Rsa76d/FaikoutRSA/PCB/FaikoutETH/production/bom.csv

Designator | Footprint | Quantity | Value | LCSC Part #
C1 | C_0603 | 1 | 10uF 35V | C22367827
C10, C12, C23, C25 | C_0402 | 4 | 22uF | C105226
C11, C13, C14, C21, C22, C24, C28, C8, C9 | C_0201 | 9 | 100nF | C66938
C2, C4 | C_0201 | 2 | 100nF 35V | C181043
C20 | C_0201 | 1 | 10pF | C76921
C26, C27 | C_0201 | 2 | 20pF | C71879
C3 | C_0201 | 1 | 33nF | C5142554
C5 | C_0805 | 1 | 100uF 6.3V | C141660
C6 | C_0201 | 1 | 1uF | C87143
D1 | SMD1615 | 1 | XL-1615RGBC-2812B | C5349954
D2, D3 | DFN1006-2L | 2 | ~ | C5137770
D4 | D_0402 | 1 | D | C28642302
D5, D6 | D_0201 | 2 | BAT30F4 | C18197832
FB3, FB4, FB5 | L_0603 | 3 | FerriteBead | C14709
J1 | JST_EH_S5B-EH_1x05_P2.50mm_Horizontal | 1 | 1x5 | C265103
J4 | RC01516 | 1 | RJ45_LED | C708636
L1 | L_6x6 | 1 | 4.7uH | C32684
Q1 | SOT-363_SC-70-6 | 1 | BSS138PS | C193381
R1, R2, R3, R7 | R_0201 | 4 | 10k | C138117
R10, R11, R4, R9 | R_0201 | 4 | 49R9 | C100141
R12 | R_0201 | 1 | 3k01 1% | C320817
R5 | R_0201 | 1 | 33k | C473534
R6 | R_0201 | 1 | 30.9k 1% | C473585
R8 | R_0201 | 1 | 10k | C106225
TR1 | B1601S | 1 | B1601S | C510548
U1 | QFN-32-1EP_5x5mm_P0.5mm_EP3.7x3.7mm-hot | 1 | KSZ8851SNL | C633272
U2 | SOT-583-8 | 1 | TPS62933 | C3200405
U4 | ESP32-S3-MINI-1 | 1 | ESP32-S3-MINI-1 | C3013941
Y1 | Crystal-3.2x2.5 | 1 | Crystal_GND24 | C5155480
