Rsa76d/FaikoutRSA/PCB/FaikoutPOE/production/bom.csv

Designator | Footprint | Quantity | Value | LCSC Part #
C1, C11, C12, C13, C3, C4, C6, C8, C9 | C_0201 | 9 | 100nF | C66938
C10, C2, C5, C7 | C_0402 | 4 | 22uF | C105226
C14, C15 | C_0201 | 2 | 20pF | C71879
C16 | C_0201 | 1 | 10pF | C76921
C17, C34 | C_0201 | 2 | 100nF | C76934
C18 | C_0603 | 1 | 10uF 35V | C22367827
C19, C21, C22 | C_0201 | 3 | 100nF 35V | C181043
C20 | C_0201 | 1 | 33nF | C5142554
C23 | C_0805 | 1 | 100uF 6.3V | C141660
C25 | C_1206 | 1 | 10uF 50V | C13585
C26 | CP_Elec_6.3x7.7 | 1 | 100uF 50V | C72478
C36 | C_0201 | 1 | 1uF
D1, D2 | D_0201 | 2 | BAT30F4 | C18197832
D10, D5 | D_0402 | 2 | D | C28642302
D11, D7 | DFN1006-2L | 2 | ~ | C5137770
D4 | SMD1615-Side | 1 | XL-1615RGBC-2812B | C5349954
D6 | D_SMA | 1 | SMAJ58A
D8, D9 | TO-269AA-BR | 2 | MB4S | C232847
F4 | Fuse_1210 | 1 | 1210L150/33WR | C42376299
FB3, FB4, FB5 | L_0603 | 3 | FerriteBead | C14709
J1 | RC01516 | 1 | RJ45_LED | C708636
J3 | JST_EH_S5B-EH_1x05_P2.50mm_Horizontal | 1 | S21 | C265103
L1 | L_6x6 | 1 | 4.7uH | C32684
L14, L15, L16, L17, L18, L19 | L_0805 | 6 | CBG201209U121T | C41330
M1 | Ag9900-LP | 1 | Ag9912-LP | C6789853
Q1, Q2 | SOT-363_SC-70-6 | 2 | BSS138PS | C193381
R1, R2, R3, R4, R5 | R_0201 | 5 | 49R9 | C100141
R10, R17 | R_0201 | 2 | 1k | C270365
R11 | R_0201 | 1 | 33k | C473534
R13, R16, R21, R22, R24, R6, R7, R9 | R_0201 | 8 | 10k | C106225
R18, R19 | R_0201 | 2 | 4k7 | C138135
R20 | R_2512 | 1 | 200 1W | C2907575
R23 | R_0201 | 1 | 30.9k 1% | C473585
R8 | R_0201 | 1 | 3k01 1% | C320817
TR1 | B1601S | 1 | B1601S | C510548
U1 | QFN-32-1EP_5x5mm_P0.5mm_EP3.7x3.7mm-hot | 1 | KSZ8851SNL | C633272
U2 | ESP32-S3-MINI-1 | 1 | ESP32-S3-MINI-1 | C3013941
U3 | SOP-4_4.4x2.6mm_P1.27mm | 1 | TCMT1100 | C118298
U5 | SOP-4_4.4x2.6mm_P1.27mm | 1 | TCMT1100 | MPN
U6 | SOT-583-8 | 1 | TPS62933 | C3200405
Y1 | Crystal-3.2x2.5 | 1 | Crystal_GND24 | C5155480
