Rsa76d/FaikoutRSA/(list of files, cad)

Other CAD files:
PCB/Faikout/FaikoutT.stl
PCB/FaikoutETH/FaikoutT.stl
PCB/FaikoutPOE/FaikoutT.stl
PCB/Faikout/FaikoutB.stl
PCB/FaikoutETH/FaikoutB.stl
PCB/FaikoutPOE/FaikoutC.stl
PCB/Faikout/FaikoutC.stl
PCB/FaikoutETH/FaikoutC.stl
PCB/FaikoutPOE/FaikoutB.stl
PCB/Faikout/FaikoutC.scad
PCB/Faikout/FaikoutT.scad
PCB/FaikoutETH/FaikoutB.scad
PCB/FaikoutETH/FaikoutC.scad
PCB/FaikoutETH/FaikoutT.scad
PCB/FaikoutPOE/FaikoutC.scad
PCB/FaikoutPOE/FaikoutT.scad
