Rsa76d/FaikoutRSA/PCB/FaikoutETH/Faikout.kicad_pcb

## KiCad design PCB/FaikoutETH/Faikout.kicad_pcb (2026-10-10)

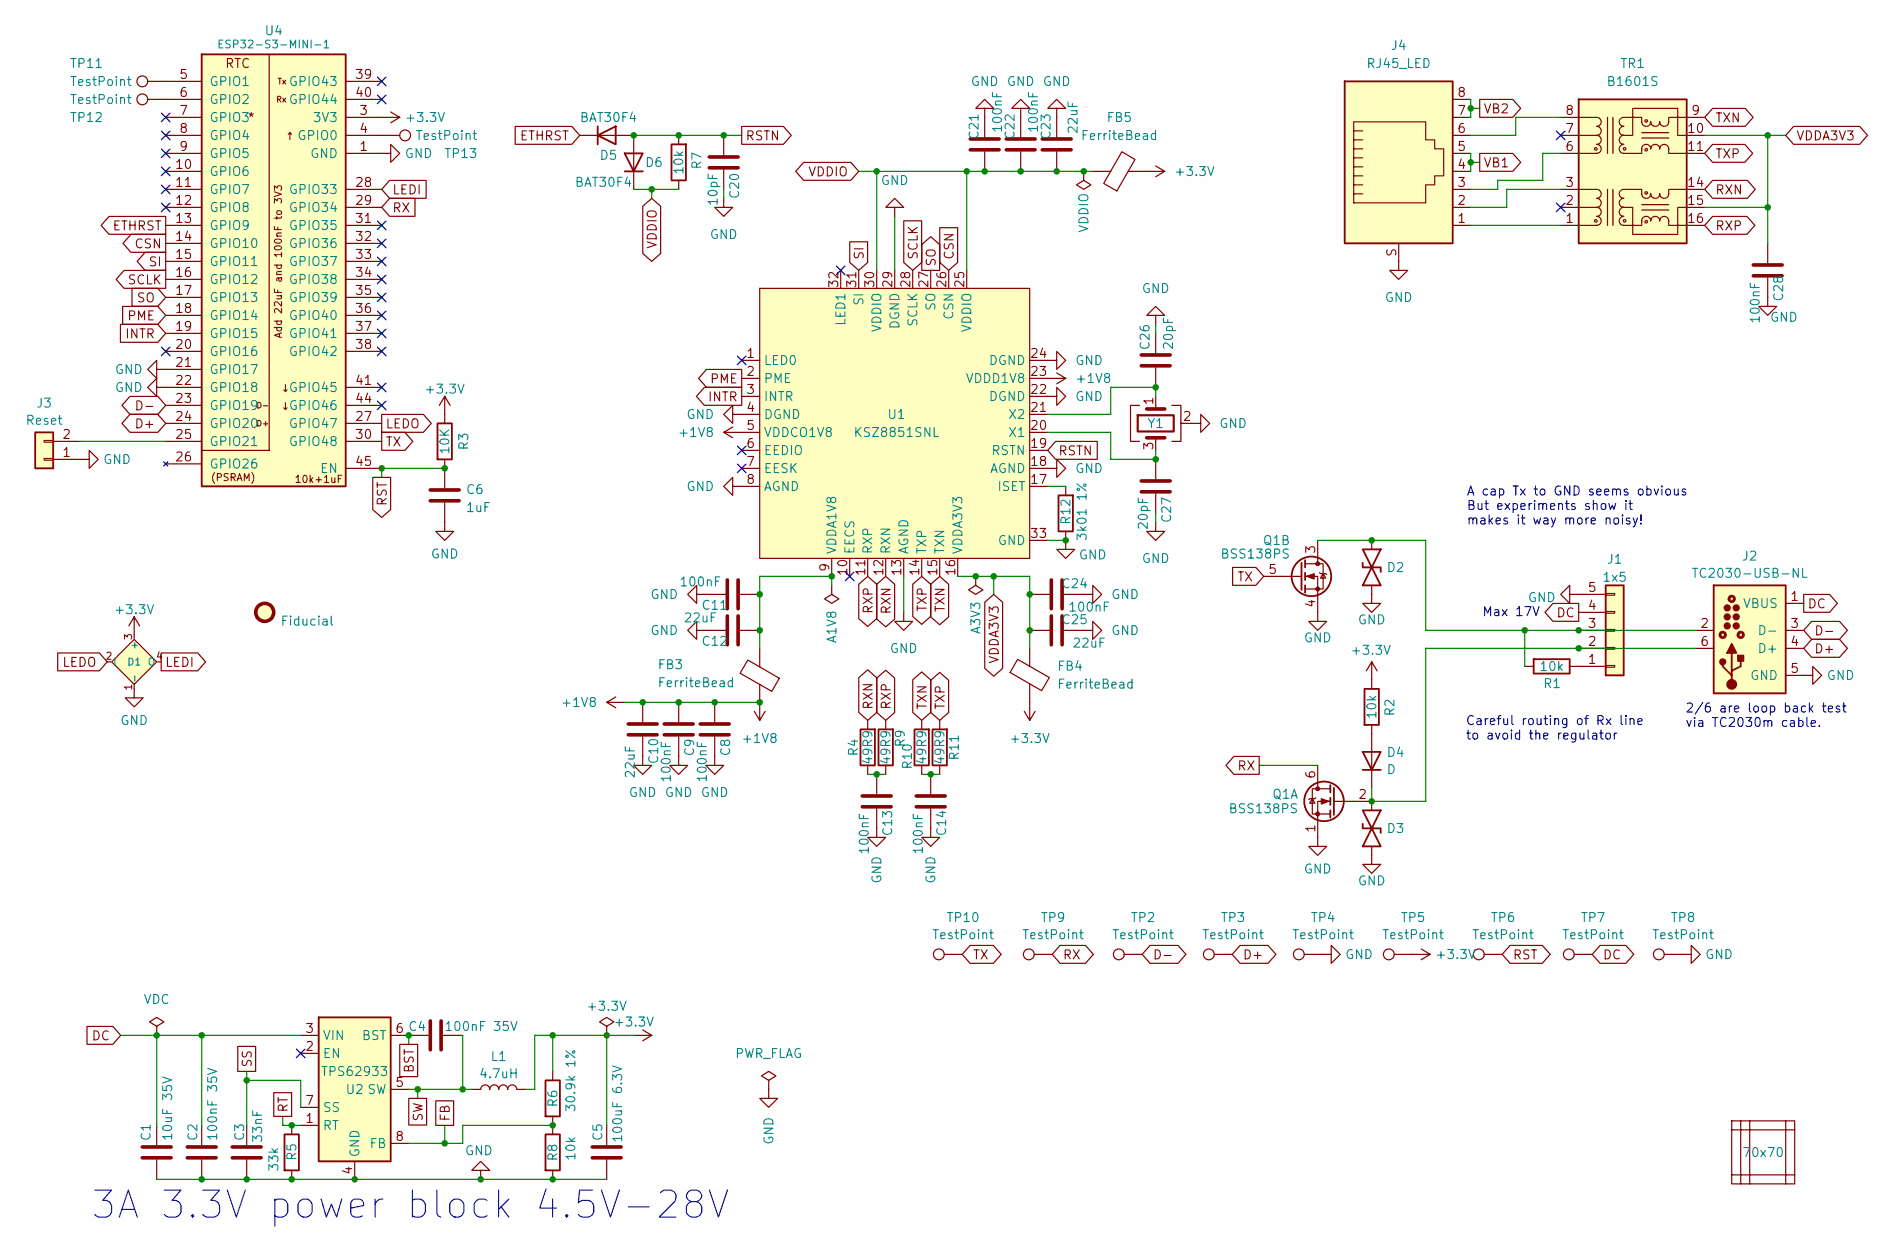
[picture p1: schematic Faikout.kicad_sch]

Parts:
C1: 10uF 35V; C_0603; MPN C22367827
C2, C4: 100nF 35V; C_0201; MPN C181043
C3: 33nF; C_0201; MPN C5142554
C5: 100uF 6.3V; C_0805; MPN C141660
C6: 1uF; C_0201; MPN C87143
C8, C9, C11, C13, C14, C21, C22, C24, C28: 100nF; C_0201; MPN C66938
C10, C12, C23, C25: 22uF; C_0402; MPN C105226
C20: 10pF; C_0201; MPN C76921
C26, C27: 20pF; C_0201; MPN C71879
D1: XL-1615RGBC-2812B; SMD1615; MPN C5349954
D2, D3: DFN1006-2L; MPN C5137770
D4: D; D_0402; MPN C28642302
D5, D6: BAT30F4; D_0201; MPN C18197832
FB3, FB4, FB5: FerriteBead; L_0603; MPN C14709
FID2: Fiducial; Fiducial_1mm_Mask2mm
J1: 1x5; JST_EH_S5B-EH_1x05_P2.50mm_Horizontal; MPN C265103
J2: TC2030-USB-NL; Tag-Connect_TC2030-IDC-NL_2x03_P1.27mm_Vertical
J3: Reset; AA-Pad
J4: RJ45_LED; RC01516; MPN C708636
L1: 4.7uH; L_6x6; MPN C32684
PCB1: 70x70; PCB7070
Q1: BSS138PS; SOT-363_SC-70-6; MPN C193381
R1, R2, R7: 10k; R_0201; MPN C138117
R3: 10K; R_0201; MPN C138117
R4, R9, R10, R11: 49R9; R_0201; MPN C100141
R5: 33k; R_0201; MPN C473534
R6: 30.9k 1%; R_0201; MPN C473585
R8: 10k; R_0201; MPN C106225
R12: 3k01 1%; R_0201; MPN C320817
TP2, TP3, TP4, TP5, TP6, TP7, TP8, TP9, TP10, TP11, TP12, TP13: TestPoint; PAD-2mm
TR1: B1601S; MPN C510548
U1: KSZ8851SNL; QFN-32-1EP_5x5mm_P0.5mm_EP3.7x3.7mm-hot; MPN C633272
U2: TPS62933; SOT-583-8; MPN C3200405
U4: ESP32-S3-MINI-1; MPN C3013941
V3, V4, V5, V6, V7: VCUT70N
Y1: Crystal_GND24; Crystal-3.2x2.5; MPN C5155480

Connections:
+1V8: C8.1, C9.1, C10.1, FB3.1, U1.5 (VDDCO1V8), U1.23 (VDDD1V8)
+3.3V: C5.1, D1.3 (+), FB4.2, FB5.2, L1.2, R2.1, R3.1, R6.1, TP5.1 (1_1), U4.3 (3V3)
BST: C4.1, U2.6 (BST)
CSN: U1.26 (CSN), U4.14 (GPIO10)
D+: J2.4 (D+), TP3.1 (1_1), U4.24 (GPIO20)
D-: J2.3 (D-), TP2.1 (1_1), U4.23 (GPIO19)
DC: C1.1, C2.1, J1.4, J2.1 (VBUS), TP7.1 (1_1), U2.3 (VIN)
ETHRST: D5.1 (K), U4.13 (GPIO9)
FB: R6.2, R8.1, U2.8 (FB)
GND: C1.2, C2.2, C3.2, C5.2, C6.2, C8.2, C9.2, C10.2, C11.2, C12.2, C13.2, C14.2, C20.2, C21.2, C22.2, C23.2, C24.2, C25.2, C26.2, C27.2, C28.2, D1.1 (-), D2.1, D3.1, J1.5, J2.5 (GND), J3.1, J4.S, Q1.1 (SN), Q1.4 (DP), R5.2, R8.2, R12.1, TP4.1 (1_1), TP8.1 (1_1), U1.4 (DGND), U1.8 (AGND), U1.13 (AGND), U1.18 (AGND), U1.22 (DGND), U1.24 (DGND), U1.29 (DGND), U1.33 (GND), U2.4 (GND), U4.1 (GND), U4.2 (GND), U4.21 (GPIO17), U4.22 (GPIO18), U4.42 (GND), U4.43 (GND), U4.46 (GND), U4.47 (GND), U4.48 (GND), U4.49 (GND), U4.50 (GND), U4.51 (GND), U4.52 (GND), U4.53 (GND), U4.54 (GND), U4.55 (GND), U4.56 (GND), U4.57 (GND), U4.58 (GND), U4.59 (GND), U4.60 (GND), U4.61 (GND), U4.62 (GND), U4.63 (GND), U4.64 (GND), U4.65 (GND), Y1.2 (G), Y1.4 (G)
INTR: U1.3 (INTR), U4.19 (GPIO15)
LEDI: D1.4 (O), U4.28 (GPIO33)
LEDO: D1.2 (I), U4.27 (GPIO47)
unnamed: C13.1, R4.1, R9.1
unnamed: C14.1, R10.1, R11.1
unnamed: D4.2 (A), R2.2
unnamed: D3.2, D4.1 (K), J1.2, J2.6, Q1.2 (GN)
unnamed: J1.1, R1.1
unnamed: D2.2, J1.3, J2.2, Q1.3 (SP), R1.2
unnamed: J3.2, U4.25 (GPIO21)
unnamed: J4.3, TR1.6 (RD+)
unnamed: J4.6, TR1.8 (RD-)
unnamed: J4.1, TR1.1 (TD+)
unnamed: J4.2, TR1.3 (TD-)
unnamed: R12.2, U1.17 (ISET)
unnamed: C11.1, C12.1, FB3.2, U1.9 (VDDA1V8)
unnamed: C27.1, U1.20 (X1), Y1.3
unnamed: C26.1, U1.21 (X2), Y1.1
unnamed: TP13.1 (1_1), U4.4 (GPIO0)
unnamed: TP11.1 (1_1), U4.5 (GPIO1)
unnamed: TP12.1 (1_1), U4.6 (GPIO2)
PME: U1.2 (PME), U4.18 (GPIO14)
RST: C6.1, R3.2, TP6.1 (1_1), U4.45 (EN)
RSTN: C20.1, D5.2 (A), D6.2 (A), R7.2, U1.19 (RSTN)
RT: R5.1, U2.1 (RT)
RX: Q1.6 (DN), TP9.1 (1_1), U4.29 (GPIO34)
RXN: R4.2, TR1.14 (TX-), U1.12 (RXN)
RXP: R9.2, TR1.16 (TX+), U1.11 (RXP)
SCLK: U1.28 (SCLK), U4.16 (GPIO12)
SI: U1.31 (SI), U4.15 (GPIO11)
SO: U1.27 (SO), U4.17 (GPIO13)
SS: C3.1, U2.7 (SS)
SW: C4.2, L1.1, U2.5 (SW)
TX: Q1.5 (GP), TP10.1 (1_1), U4.30 (GPIO48)
TXN: R10.2, TR1.9 (RX-), U1.15 (TXN)
TXP: R11.2, TR1.11 (RX+), U1.14 (TXP)
VB1: J4.4, J4.5
VB2: J4.7, J4.8
VDDA3V3: C24.1, C25.1, C28.1, FB4.1, TR1.10 (C_RX), TR1.15 (C_TX), U1.16 (VDDA3V3)
VDDIO: C21.1, C22.1, C23.1, D6.1 (K), FB5.1, R7.1, U1.25 (VDDIO), U1.30 (VDDIO)

Notes on the sheet:
Careful routing of Rx line to avoid the regulator
Max 17V
2/6 are loop back test via TC2030m cable.
A cap Tx to GND seems obvious But experiments show it makes it way more noisy!
3A 3.3V power block 4.5V-28V

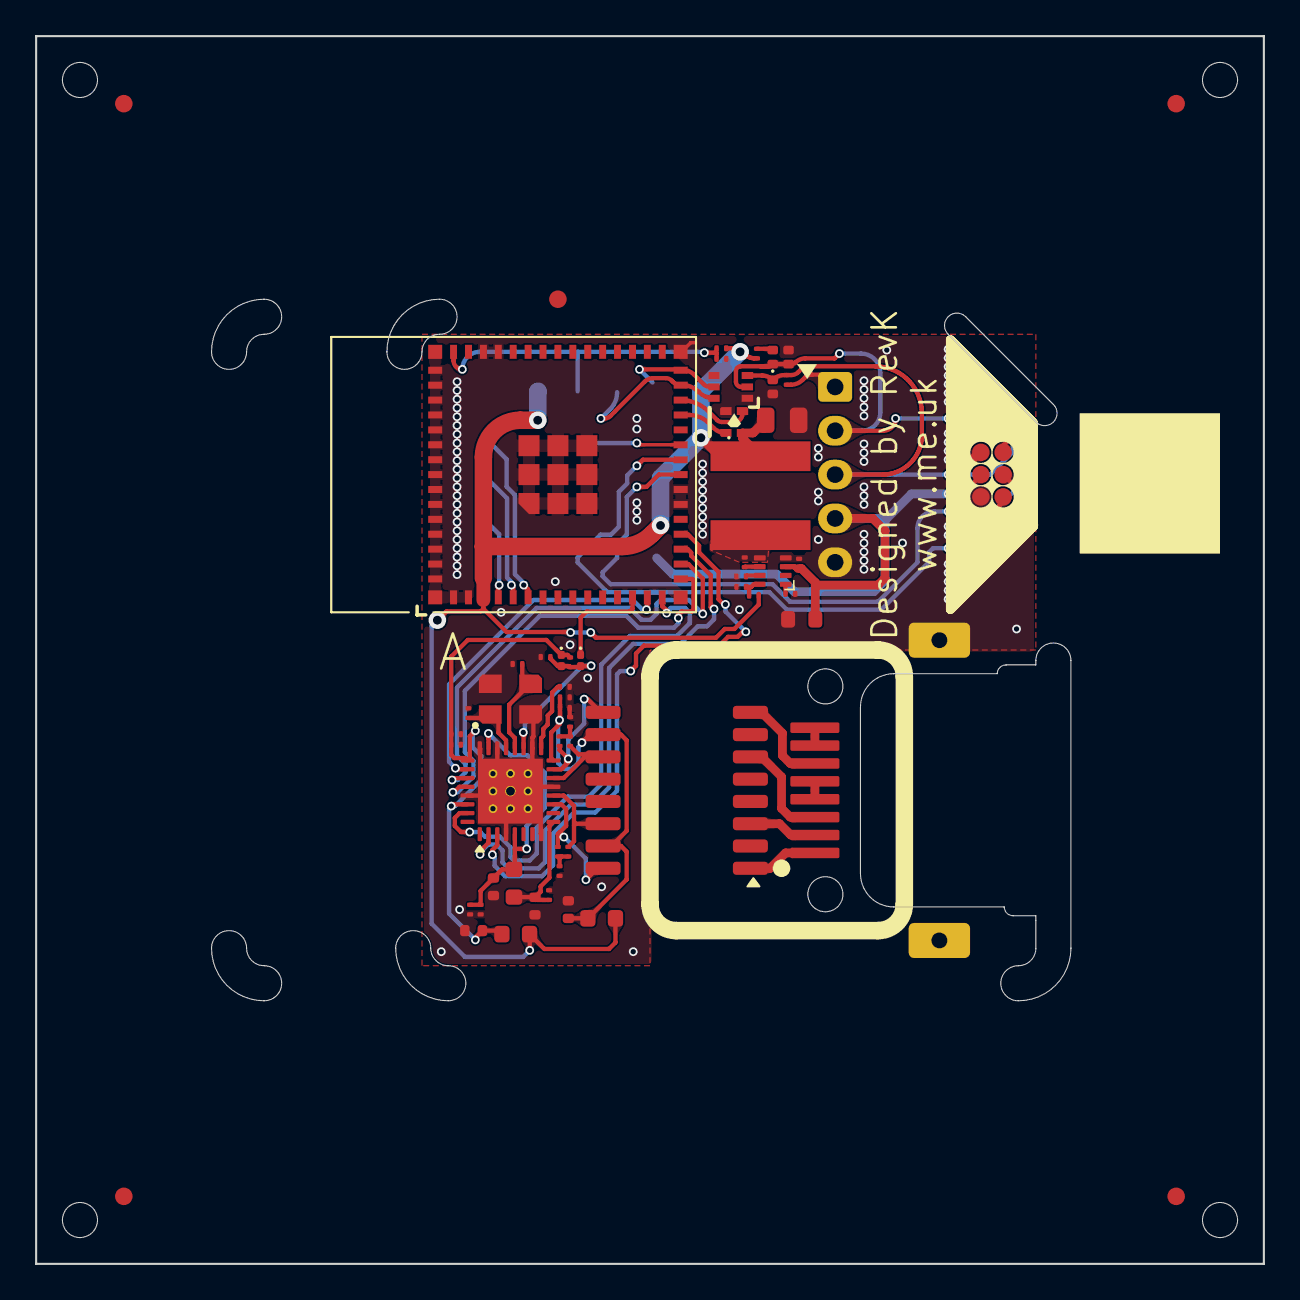
[picture p2: board PCB/FaikoutETH/Faikout.kicad_pcb from above]

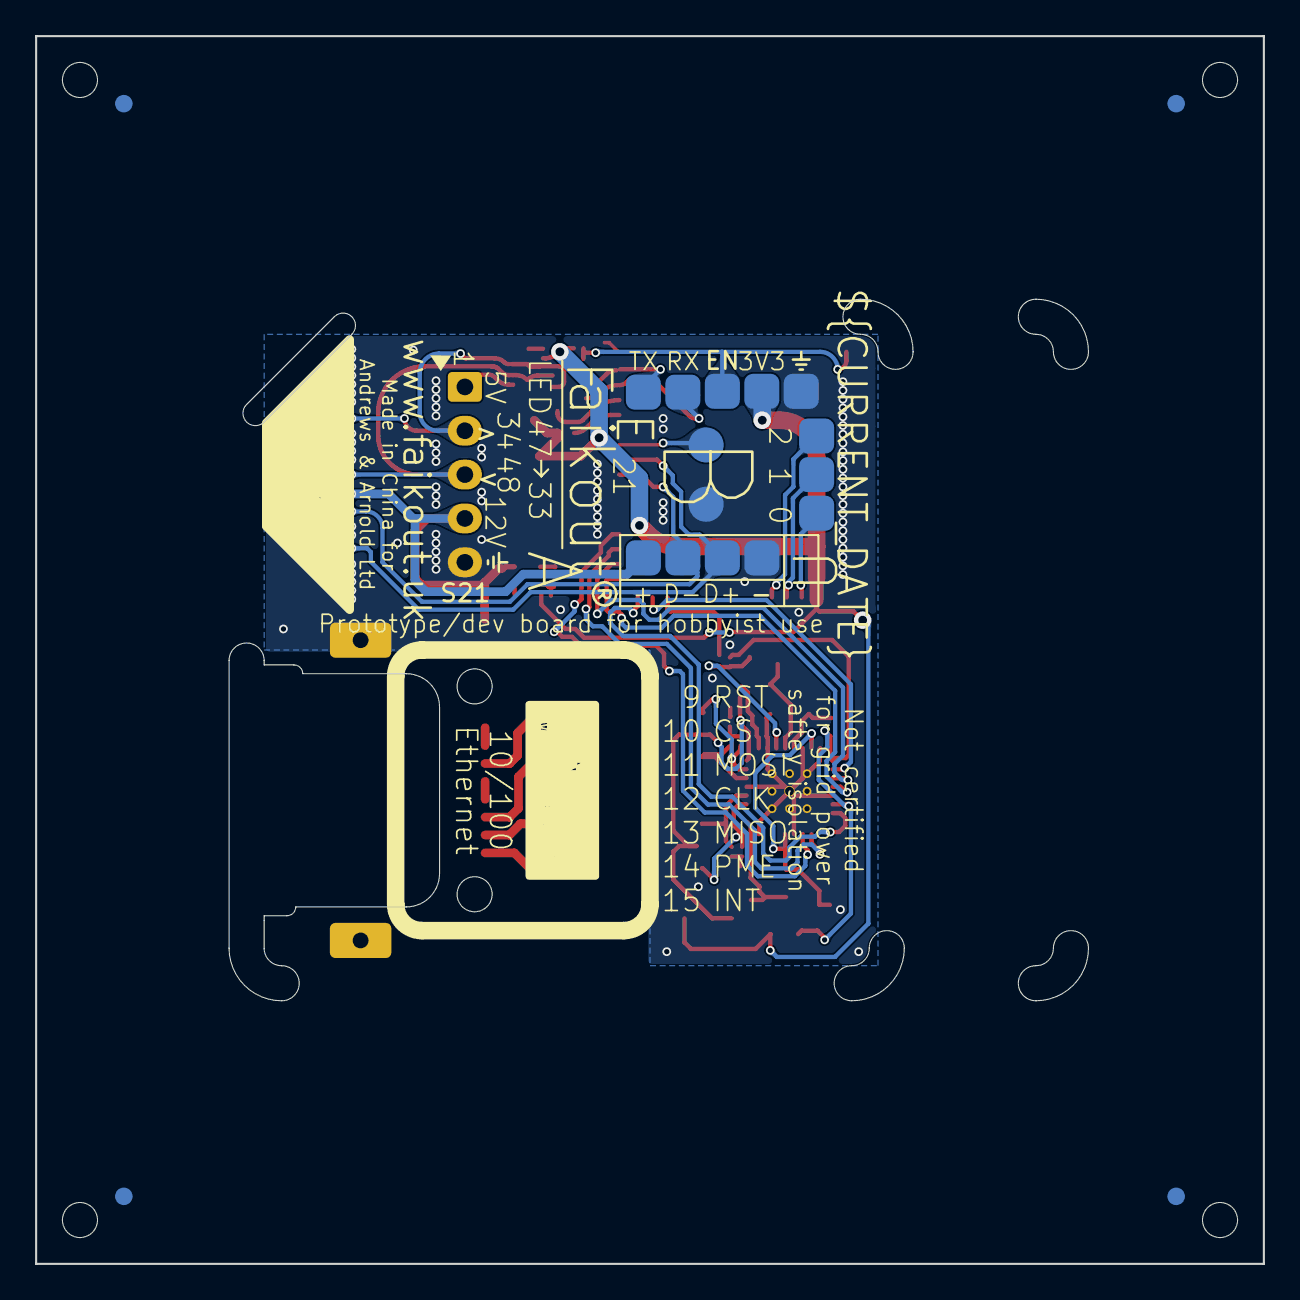
[picture p3: board PCB/FaikoutETH/Faikout.kicad_pcb from below]

Board: 2 copper layers, 70.0 x 70.0 mm, 73 parts (14 on the bottom side), 50 nets.
