Rsa76d/FaikoutRSA/PCB/FaikoutPOE/Faikout.kicad_pcb

## KiCad design PCB/FaikoutPOE/Faikout.kicad_pcb (2026-10-10)

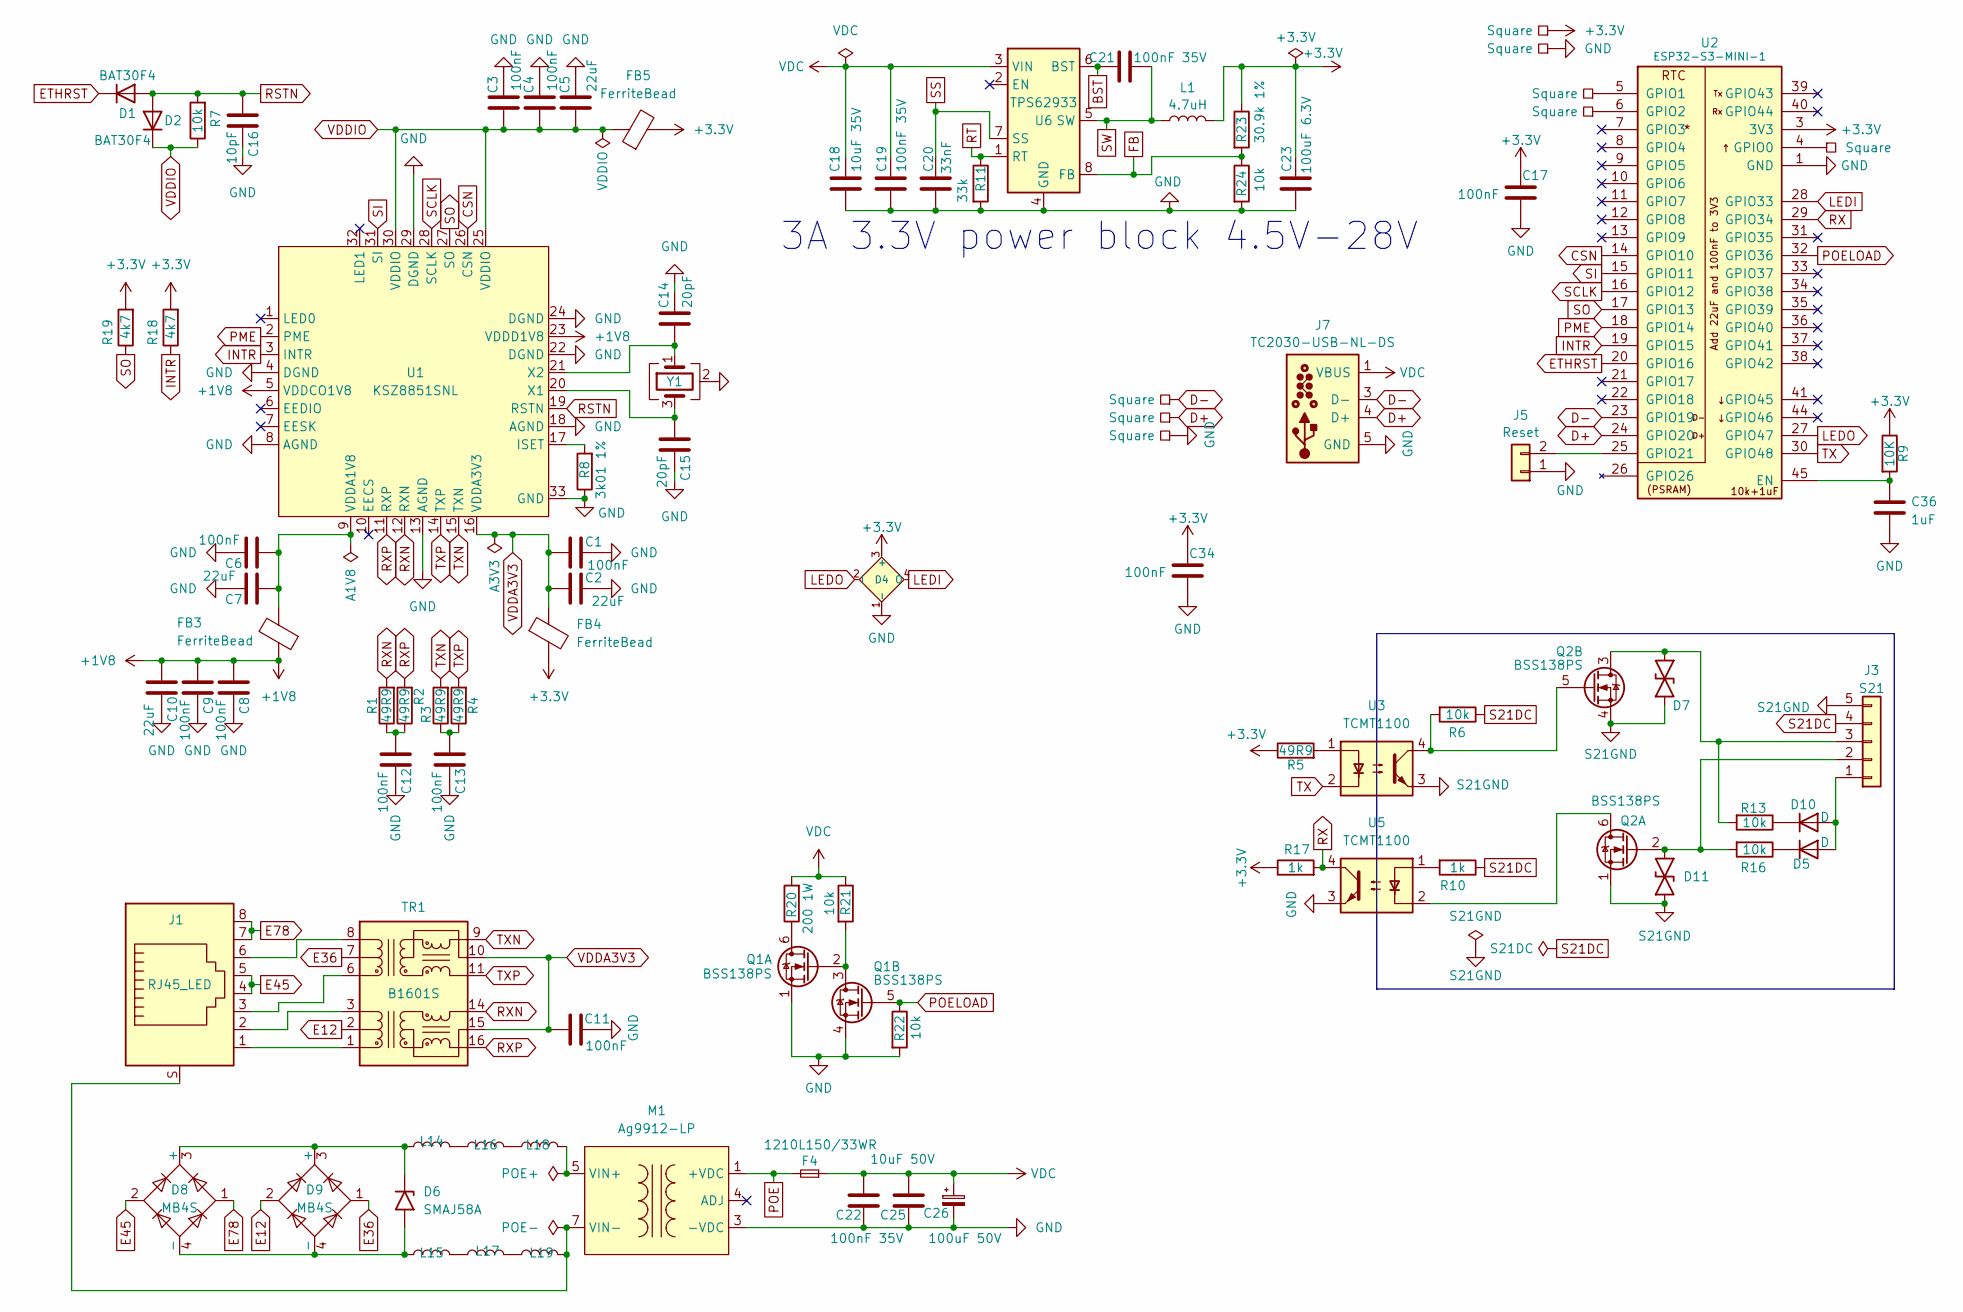
[picture p4: schematic Faikout.kicad_sch]

Parts:
C1, C3, C4, C6, C8, C9, C11, C12, C13: 100nF; C_0201; MPN C66938
C2, C5, C7, C10: 22uF; C_0402; MPN C105226
C14, C15: 20pF; C_0201; MPN C71879
C16: 10pF; C_0201; MPN C76921
C17, C34: 100nF; C_0201; MPN C76934
C18: 10uF 35V; C_0603; MPN C22367827
C19, C21, C22: 100nF 35V; C_0201; MPN C181043
C20: 33nF; C_0201; MPN C5142554
C23: 100uF 6.3V; C_0805; MPN C141660
C25: 10uF 50V; C_1206; MPN C13585
C26: 100uF 50V; CP_Elec_6.3x7.7; MPN C72478
C36: 1uF; C_0201
D1, D2: BAT30F4; D_0201; MPN C18197832
D4: XL-1615RGBC-2812B; SMD1615-Side; MPN C5349954
D5, D10: D; D_0402; MPN C28642302
D6: SMAJ58A; D_SMA
D7, D11: DFN1006-2L; MPN C5137770
D8, D9: MB4S; TO-269AA-BR; MPN C232847
F4: 1210L150/33WR; Fuse_1210; MPN C42376299
FB3, FB4, FB5: FerriteBead; L_0603; MPN C14709
J1: RJ45_LED; RC01516; MPN C708636
J3: S21; JST_EH_S5B-EH_1x05_P2.50mm_Horizontal; MPN C265103
J5: Reset; AA-Pad
J7: TC2030-USB-NL-DS; Tag-Connect_TC2030-IDC-NL_2x03_P1.27mm_Vertical
L1: 4.7uH; L_6x6; MPN C32684
L14, L15, L16, L17, L18, L19: CBG201209U121T; L_0805; MPN C41330
M1: Ag9912-LP; Ag9900-LP; MPN C6789853
P1, P2, P3, P4, P5, P6, P7, P8: Square; PAD-2mm
Q1, Q2: BSS138PS; SOT-363_SC-70-6; MPN C193381
R1, R2, R3, R4, R5: 49R9; R_0201; MPN C100141
R6, R7, R13, R16, R21, R22, R24: 10k; R_0201; MPN C106225
R8: 3k01 1%; R_0201; MPN C320817
R9: 10K; R_0201; MPN C106225
R10, R17: 1k; R_0201; MPN C270365
R11: 33k; R_0201; MPN C473534
R18, R19: 4k7; R_0201; MPN C138135
R20: 200 1W; R_2512; MPN C2907575
R23: 30.9k 1%; R_0201; MPN C473585
TR1: B1601S; MPN C510548
U1: KSZ8851SNL; QFN-32-1EP_5x5mm_P0.5mm_EP3.7x3.7mm-hot; MPN C633272
U2: ESP32-S3-MINI-1; MPN C3013941
U3: TCMT1100; SOP-4_4.4x2.6mm_P1.27mm; MPN C118298
U5: TCMT1100; SOP-4_4.4x2.6mm_P1.27mm; MPN MPN
U6: TPS62933; SOT-583-8; MPN C3200405
Y1: Crystal_GND24; Crystal-3.2x2.5; MPN C5155480

Connections:
+1V8: C8.1, C9.1, C10.1, FB3.1, U1.5 (VDDCO1V8), U1.23 (VDDD1V8)
+3.3V: C17.2, C23.1, C34.2, D4.3 (+), FB4.2, FB5.2, L1.2, P7.1 (P_1), R5.1, R9.1, R17.1, R18.2, R19.2, R23.1, U2.3 (3V3)
BST: C21.1, U6.6 (BST)
CSN: U1.26 (CSN), U2.14 (GPIO10)
D+: J7.4 (D+), P3.1 (P_1), U2.24 (GPIO20)
D-: J7.2 (NC), J7.3 (D-), J7.6 (NC), P2.1 (P_1), U2.23 (GPIO19)
E12: D9.2, TR1.2 (C_TD)
E36: D9.1, TR1.7 (C_RD)
E45: D8.2, J1.4, J1.5
E78: D8.1, J1.7, J1.8
ETHRST: D1.1 (K), U2.20 (GPIO16)
FB: R23.2, R24.1, U6.8 (FB)
GND: C1.2, C2.2, C3.2, C4.2, C5.2, C6.2, C7.2, C8.2, C9.2, C10.2, C11.2, C12.2, C13.2, C14.2, C15.2, C16.2, C17.1, C18.2, C19.2, C20.2, C22.2, C23.2, C25.1, C26.2, C34.1, C36.2, D4.1 (-), J5.1, J7.5 (GND), M1.3 (-VDC), P4.1 (P_1), P8.1 (P_1), Q1.1 (SN), Q1.4 (DP), R8.1, R11.2, R22.2, R24.2, U1.4 (DGND), U1.8 (AGND), U1.13 (AGND), U1.18 (AGND), U1.22 (DGND), U1.24 (DGND), U1.29 (DGND), U1.33 (GND), U2.1 (GND), U2.2 (GND), U2.42 (GND), U2.43 (GND), U2.46 (GND), U2.47 (GND), U2.48 (GND), U2.49 (GND), U2.50 (GND), U2.51 (GND), U2.52 (GND), U2.53 (GND), U2.54 (GND), U2.55 (GND), U2.56 (GND), U2.57 (GND), U2.58 (GND), U2.59 (GND), U2.60 (GND), U2.61 (GND), U2.62 (GND), U2.63 (GND), U2.64 (GND), U2.65 (GND), U5.3, U6.4 (GND), Y1.2 (G), Y1.4 (G)
INTR: R18.1, U1.3 (INTR), U2.19 (GPIO15)
LEDI: D4.4 (O), U2.28 (GPIO33)
LEDO: D4.2 (I), U2.27 (GPIO47)
unnamed: C12.1, R1.1, R2.1
unnamed: C13.1, R3.1, R4.1
unnamed: D5.1 (K), R16.1
unnamed: D6.1 (A1), D8.3 (+), D9.3 (+), L14.1
unnamed: D6.2 (A2), D8.4 (-), D9.4 (-), L15.1
unnamed: D5.2 (A), D10.2 (A), J3.1
unnamed: D10.1 (K), R13.1
unnamed: D11.1, J3.2, Q2.2 (GN), R16.2
unnamed: D7.2, J3.3, Q2.3 (SP), R13.2
unnamed: J5.2, U2.25 (GPIO21)
unnamed: L14.2, L16.1
unnamed: L15.2, L17.1
unnamed: L16.2, L18.1
unnamed: L17.2, L19.1
unnamed: P1.1 (P_1), U2.4 (GPIO0)
unnamed: P5.1 (P_1), U2.5 (GPIO1)
unnamed: P6.1 (P_1), U2.6 (GPIO2)
unnamed: Q1.6 (DN), R20.1
unnamed: Q1.2 (GN), Q1.3 (SP), R21.2
unnamed: Q2.6 (DN), U5.2
unnamed: Q2.5 (GP), R6.2, U3.4
unnamed: R5.2, U3.1
unnamed: R10.2, U5.1
unnamed: J1.3, TR1.6 (RD+)
unnamed: J1.6, TR1.8 (RD-)
unnamed: J1.1, TR1.1 (TD+)
unnamed: J1.2, TR1.3 (TD-)
unnamed: R8.2, U1.17 (ISET)
unnamed: C6.1, C7.1, FB3.2, U1.9 (VDDA1V8)
unnamed: C15.1, U1.20 (X1), Y1.3
unnamed: C14.1, U1.21 (X2), Y1.1
unnamed: C36.1, R9.2, U2.45 (EN)
PME: U1.2 (PME), U2.18 (GPIO14)
POE: F4.2, M1.1 (+VDC), M1.2 (+VDC)
POELOAD: Q1.5 (GP), R22.1, U2.32 (GPIO36)
RSTN: C16.1, D1.2 (A), D2.2 (A), R7.2, U1.19 (RSTN)
RT: R11.1, U6.1 (RT)
RX: R17.2, U2.29 (GPIO34), U5.4
RXN: R1.2, TR1.14 (TX-), U1.12 (RXN)
RXP: R2.2, TR1.16 (TX+), U1.11 (RXP)
S21DC: J3.4, R6.1, R10.1
S21GND: D7.1, D11.2, J3.5, Q2.1 (SN), Q2.4 (DP), U3.3
SCLK: U1.28 (SCLK), U2.16 (GPIO12)
SI: U1.31 (SI), U2.15 (GPIO11)
SO: R19.1, U1.27 (SO), U2.17 (GPIO13)
SS: C20.1, U6.7 (SS)
SW: C21.2, L1.1, U6.5 (SW)
TX: U2.30 (GPIO48), U3.2
TXN: R3.2, TR1.9 (RX-), U1.15 (TXN)
TXP: R4.2, TR1.11 (RX+), U1.14 (TXP)
VDC: C18.1, C19.1, C22.1, C25.2, C26.1, F4.1, J7.1 (VBUS), R20.2, R21.1, U6.3 (VIN)
VDDA3V3: C1.1, C2.1, C11.1, FB4.1, TR1.10 (C_RX), TR1.15 (C_TX), U1.16 (VDDA3V3)
VDDIO: C3.1, C4.1, C5.1, D2.1 (K), FB5.1, R7.1, U1.25 (VDDIO), U1.30 (VDDIO)
VIN+: L18.2, M1.5 (VIN+), M1.6 (VIN+)
VIN-: J1.S, L19.2, M1.7 (VIN-), M1.8 (VIN-)

Notes on the sheet:
3A 3.3V power block 4.5V-28V

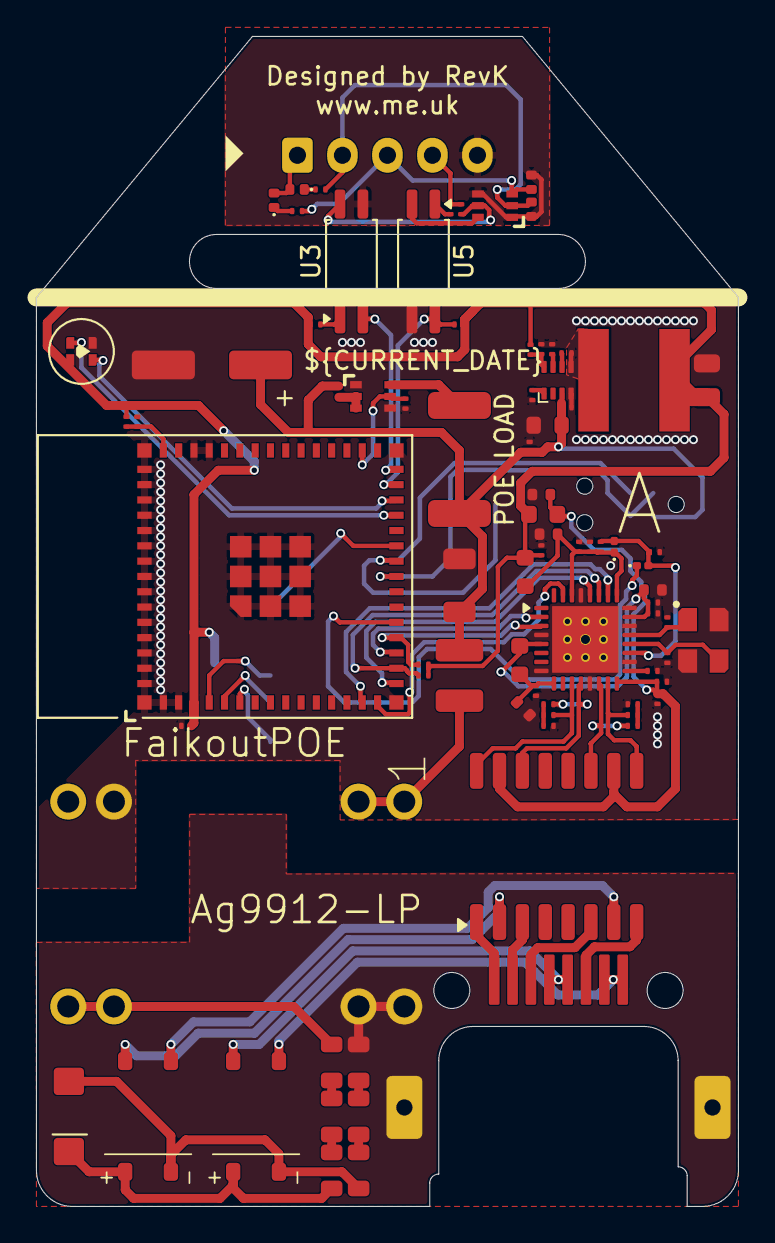
[picture p5: board PCB/FaikoutPOE/Faikout.kicad_pcb from above]

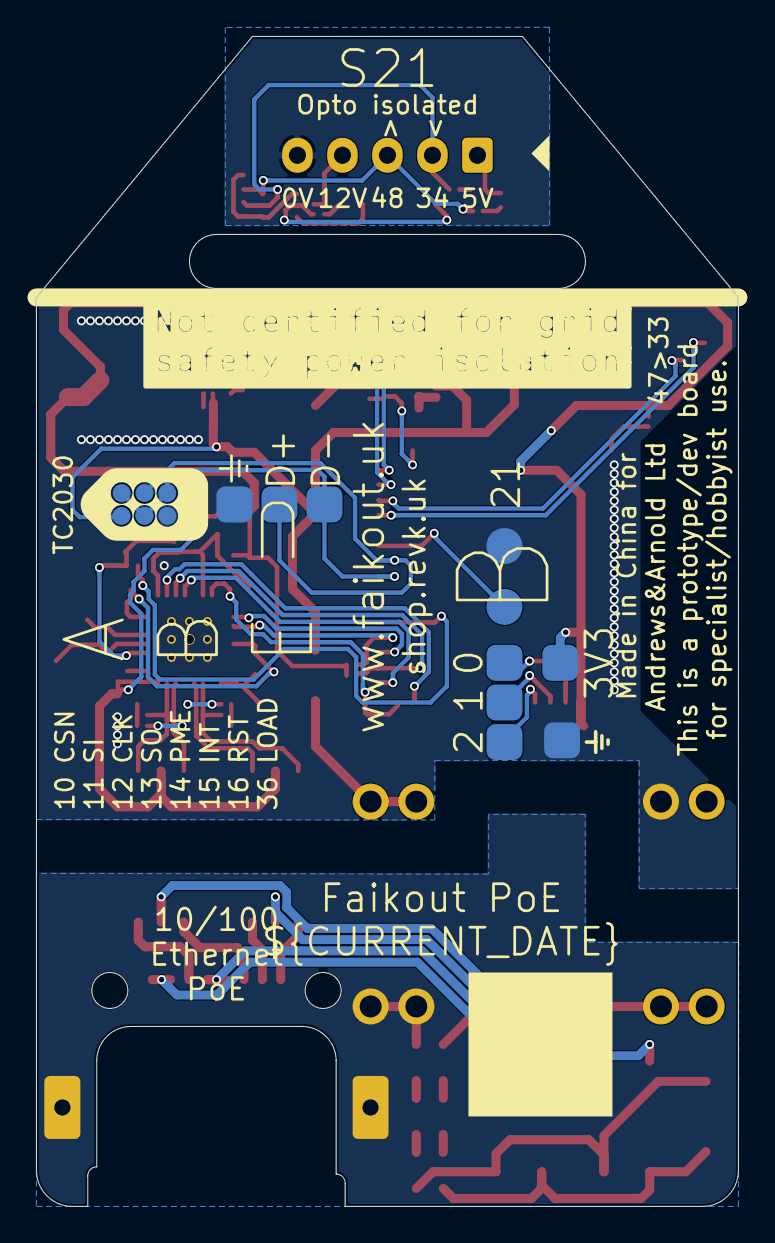
[picture p6: board PCB/FaikoutPOE/Faikout.kicad_pcb from below]

Board: 2 copper layers, 39.0 x 65.0 mm, 91 parts (10 on the bottom side), 71 nets.
