Rsa76d/FaikoutRSA/(commit log)

2026-06-06 Removed pico as not building on ESP IDF v6 at present (may be possible in time)
2026-06-11 web: reap dead WebSocket sockets to fix permanent web-server wedge
    On a marginal link, abandoned /status WebSocket sessions (closed tab or lost link with no clean FIN) were never reclaimed: the async send return was ignored and there was no TCP keep-alive, so each dead session held a socket slot until max_open_sockets was exhausted and httpd accepted TCP but returned empty HTTP (MQTT unaffected, heap healthy). Enable httpd keep-alive and close the session on a failed async WS send. Same fix as the ESP32-RevK /revk-status handler. Addresses #299/#997.
2026-06-12 Ethernet board
2026-06-12 Ethernet case
2026-06-12 Fix case
2026-06-13 ETH board
2026-06-13 POE board
2026-06-13 New PCB
2026-06-14 Case tweak
2026-06-19 Fix case size, ejit
2026-06-20 Tweak case
2026-06-20 Re render, URL added to case
2026-06-22 Revised case cut
2026-06-25 New footprint
2026-06-25 Fan order in HA
2026-06-25 Fan fix
2026-06-29 New regulator
2026-07-10 Fix BOM
2026-08-17 Red PCBs
2026-08-20 New case tools
2026-09-12 General save from my mac (used mainly for PCB work)
2026-09-14 fix #1094 auto fan run on
2026-10-16 Add bootloader offsets for other boards to flashing notes
    Claude-Session: https://claude.ai/code/session_01YbxYuJrCNBr4ri8qHJUc9c
